mczerski/Safe-PI-Shutdown/safe_pi_shutdown.kicad_pcb

## KiCad design safe_pi_shutdown.kicad_pcb (2019-01-16)

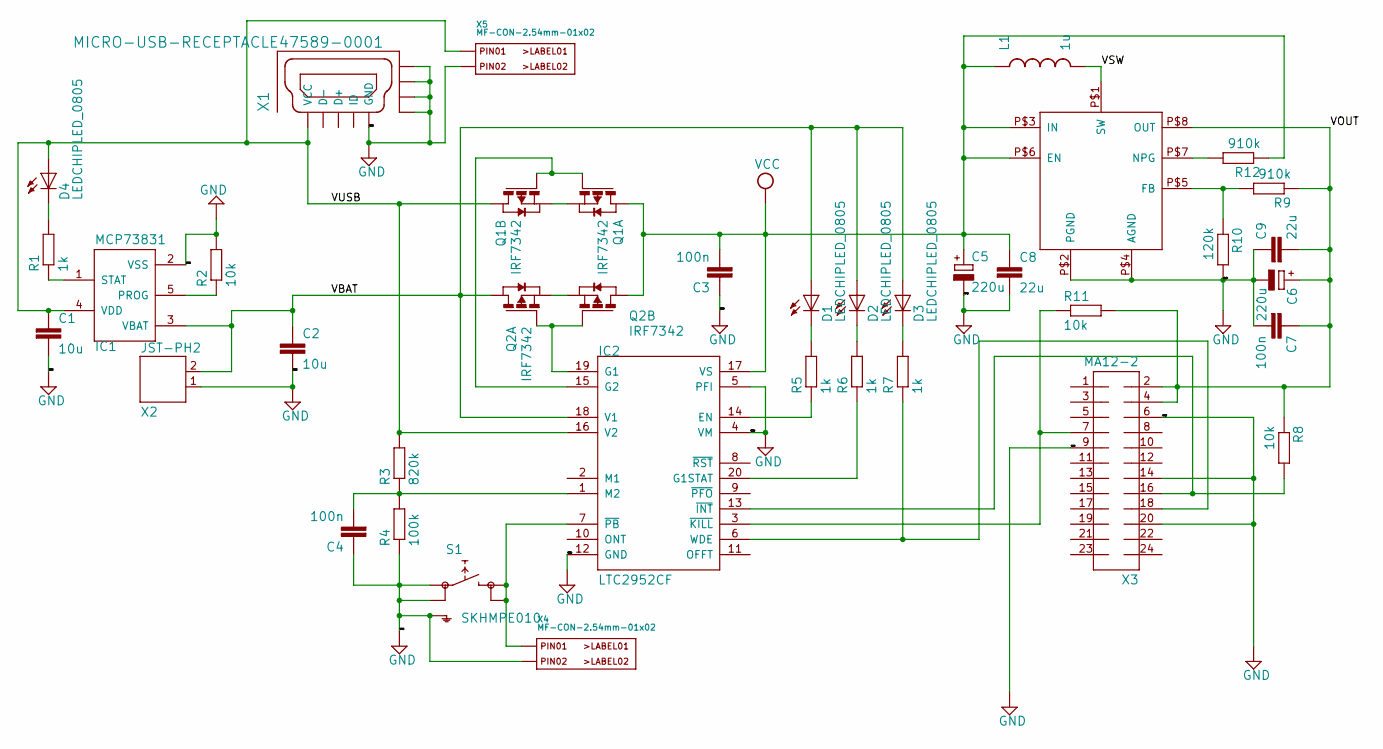
[picture p1: schematic safe_pi_shutdown.sch]

Parts:
C1, C2: 10u; C0603
C3, C4, C7: 100n; C0402
C5, C6: 220u; E3,5-8
C8, C9: 22u; C0603
D1, D2, D3, D4: LEDCHIPLED_0805; CHIPLED_0805
IC1: MCP73831; SOT23-5L
IC2: LTC2952CF; SSOP20
IC3: MIC2876
L1: 1u; CR54-KIT
Q1, Q2: IRF7342; SO8
R1, R5, R6, R7: 1k; R0603
R2, R8, R11: 10k; R0603
R3: 820k; R0603
R4: 100k; R0603
R9, R12: 910k; R0603
R10: 120k; R0603
S1: SKHMPE010; SKHMPXE010
X1: MICRO-USB-RECEPTACLE47589-0001; 47589-0001
X2: JST-PH2
X3: MA12-2
X4, X5: MF-CON-2.54mm-01x02; PTH_2.54MM_01X02

Connections:
/VBAT: C2.1, D1.A, D2.A, D3.A, IC1.3 (VBAT), IC2.18 (V1), Q2.7 (D), Q2.8 (D), X2.2
/VOUT: C6.+, C7.1, C9.2, IC3.P$8 (OUT), R8.1, R9.1, R11.2, X3.2, X3.4
/VSW: IC3.P$1 (SW), L1.P$2 (2)
/VUSB: C1.1, D4.A, IC1.4 (VDD), IC2.16 (V2), Q1.5 (D), Q1.6 (D), R3.2, X1.1 (VCC), X5.P$1 (PIN1)
GND: C1.2, C2.2, C3.1, C4.1, C5.-, C6.-, C7.2, C8.2, C9.1, IC1.2 (VSS), IC2.4 (VM), IC2.5 (PFI), IC2.12 (GND), IC3.P$2 (PGND), IC3.P$4 (AGND), R2.2, R4.1, R10.2, S1.1 (1.1), S1.2 (1.2), S1.5 (SH), X1.5 (GND), X1.CASING1 (GND1), X1.CASING2 (GND2), X1.CASING3 (GND3), X1.CASING4 (GND4), X2.1, X3.6, X3.9, X3.14, X3.20, X4.P$2 (PIN2), X5.P$2 (PIN2)
unnamed: C4.2, IC2.1 (M2), R3.1, R4.2
unnamed: D1.C, R5.2
unnamed: D2.C, R6.2
unnamed: D3.C, R7.2
unnamed: D4.C, R1.2
unnamed: IC1.1 (STAT), R1.1
unnamed: IC1.5 (PROG), R2.1
unnamed: IC2.3 (~KILL), R11.1, X3.7
unnamed: IC2.6 (WDE), R7.1, X3.18
unnamed: IC2.7 (~PB), S1.3 (2.1), S1.4 (2.2), X4.P$1 (PIN1)
unnamed: IC2.13 (~INT), R8.2, X3.16
unnamed: IC2.14 (EN), R5.1
unnamed: IC2.15 (G2), Q1.2 (G), Q1.4 (G)
unnamed: IC2.19 (G1), Q2.2 (G), Q2.4 (G)
unnamed: IC2.20 (G1STAT), R6.1
unnamed: IC3.P$5 (FB), R9.2, R10.1
unnamed: IC3.P$7 (NPG), R12.2
unnamed: Q1.1 (S), Q1.3 (S)
unnamed: Q2.1 (S), Q2.3 (S)
VCC: C3.2, C5.+, C8.1, IC2.17 (VS), IC3.P$3 (IN), IC3.P$6 (EN), L1.P$1 (1), Q1.7 (D), Q1.8 (D), Q2.5 (D), Q2.6 (D), R12.1

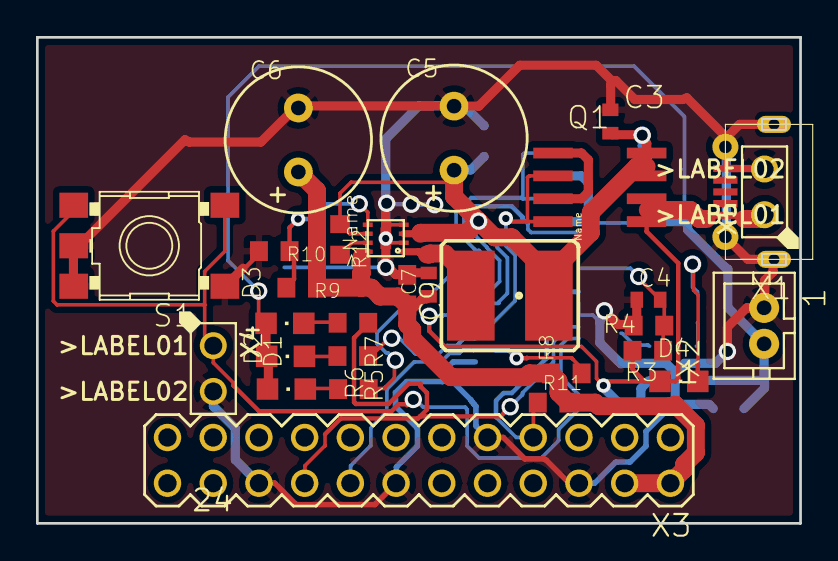
[picture p2: board safe_pi_shutdown.kicad_pcb from above]

Board: 2 copper layers, 42.4 x 27.0 mm, 37 parts (0 on the bottom side), 25 nets.
