mczerski/Safe-PI-Shutdown/(commit log)

2017-04-26 pierwszy commit
    [safe_pi_shutdown.brd, safe_pi_shutdown.sch]
2017-04-26 prawie pierwsza wersja
    [safe_pi_shutdown.brd, safe_pi_shutdown.sch]
2017-04-27 polaczone wszystkie sciezki
    [safe_pi_shutdown.brd]
2017-04-28 rozmieszczenie nazw na layaoucie
    [safe_pi_shutdown.brd, safe_pi_shutdown.sch]
2017-04-28 dostosowanie do nanopi zero (pozycja konektora)
    [safe_pi_shutdown.brd, safe_pi_shutdown.sch]
2017-04-29 dodanie headerow do podlaczenia do plyty bazowej
    [safe_pi_shutdown.brd, safe_pi_shutdown.sch]
2017-05-06 zmiana micro usb, poprawki z kondensatorami i inne
    [safe_pi_shutdown.brd, safe_pi_shutdown.sch]
2017-05-06 przyciecie plytki do minimum
    [safe_pi_shutdown.brd]
2017-05-21 nie wiem jakie zmiany
    [safe_pi_shutdown.brd]
2017-06-15 dodanie pull-up dla pinu INT
    [safe_pi_shutdown.brd, safe_pi_shutdown.sch]
2017-07-16 boost converter changed to MIC2876
    [safe_pi_shutdown.brd, safe_pi_shutdown.sch]
2019-01-13 add more capacitors to power path
    [safe_pi_shutdown.brd, safe_pi_shutdown.sch]
2019-01-16 convert eagle to kicad
    [safe_pi_shutdown.kicad_pcb, safe_pi_shutdown.sch]
2019-01-16 remove eagle project
    [safe_pi_shutdown.brd]
2021-04-09 changes made automatically after opening project in newest kickad
    + added gitignore
    [safe_pi_shutdown.sch]
