mczerski/Safe-PI-Shutdown/(notices)

Notices in the files:
parts and their libraries:
(C) 2014 Tomasz Boleslaw CEDRO, cederom@tlen.pl, http://www.tomek.cedro.info.
